PaintX/LSU_4-9_O2_Sensor_Controller/README.md

# LSU_4-9_O2_Sensor_Controller
Controlleur pour sonde lambda LSU 4.9 avec arduino
