PaintX/LSU_4-9_O2_Sensor_Controller/(list of files, drawings)

Other design files:
Orig/schematics/HF-TeensyPP20.pcb
