PaintX/LSU_4-9_O2_Sensor_Controller/PCB/LO2SC.kicad_pcb

## KiCad design PCB/LO2SC.kicad_pcb (2015-09-24)

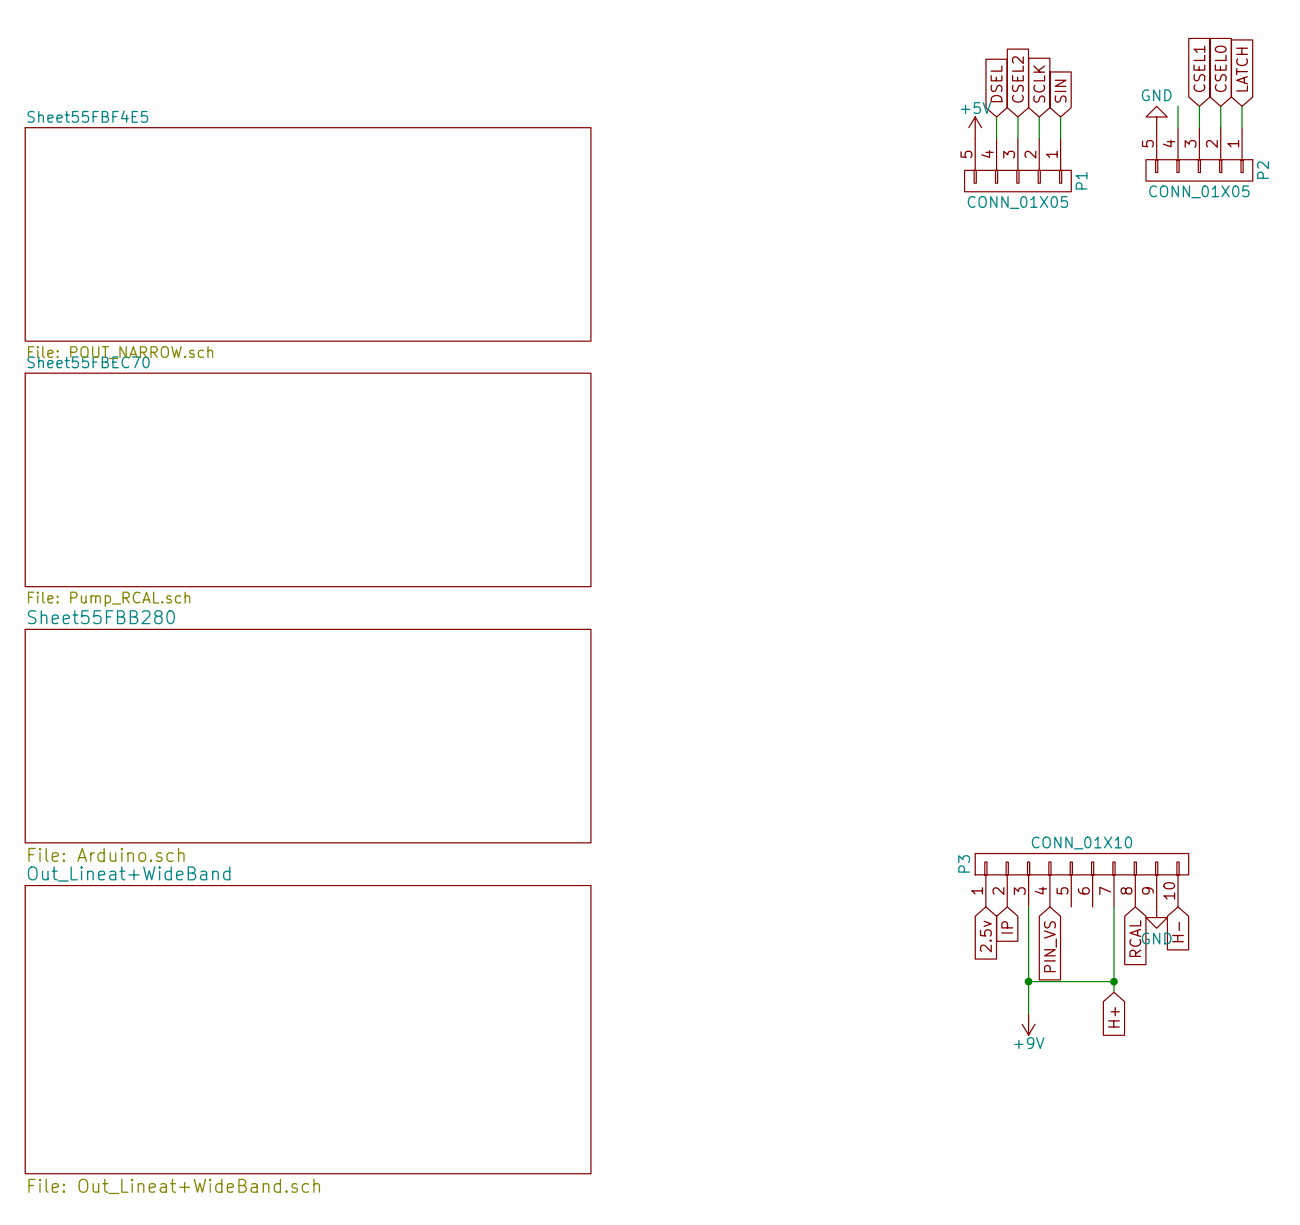
[picture p1: schematic LO2SC.sch]

Parts:
P1, P2: CONN_01X05; Pin_Header_Straight_1x05
P3: CONN_01X10; JAE_10Pins

Connections:
2.5v: P3.1; also elsewhere on the board
+5V: P1.5; also elsewhere on the board
CSEL0: P2.2; also elsewhere on the board
CSEL1: P2.3; also elsewhere on the board
CSEL2: P1.3; also elsewhere on the board
DSEL: P1.4; also elsewhere on the board
GND: P2.5, P3.9; also elsewhere on the board
H+: P3.3, P3.7
IP: P3.2; also elsewhere on the board
LATCH: P2.1; also elsewhere on the board
PIN_VS: P3.4; also elsewhere on the board
RCAL: P3.8; also elsewhere on the board
SCLK: P1.2; also elsewhere on the board
SIN: P1.1; also elsewhere on the board

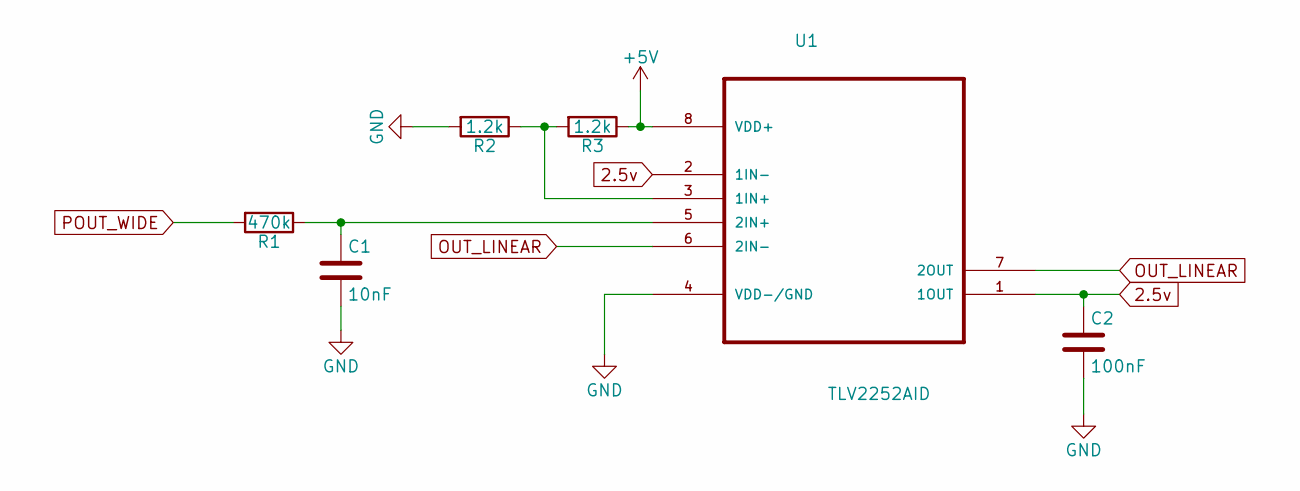
[picture p2: schematic Out_Lineat+WideBand.sch]

Parts:
C1: 10nF; C_0603_HandSoldering
C2: 100nF; C_0603_HandSoldering
R1: 470k; R_0603_HandSoldering
R2, R3: 1.2k; R_0603_HandSoldering
U1: TLV2252AID; SOIC127P600X175-8N

Connections:
2.5v: C2.1, U1.1 (1OUT), U1.2 (1IN-); also elsewhere on the board
+5V: R3.1, U1.8 (VDD+); also elsewhere on the board
GND: C1.2, C2.2, R2.2, U1.4 (VDD-/GND); also elsewhere on the board
unnamed: C1.1, R1.1, U1.5 (2IN+)
unnamed: R2.1, R3.2, U1.3 (1IN+)
OUT_LINEAR: U1.6 (2IN-), U1.7 (2OUT)
POUT_WIDE: R1.2; also elsewhere on the board

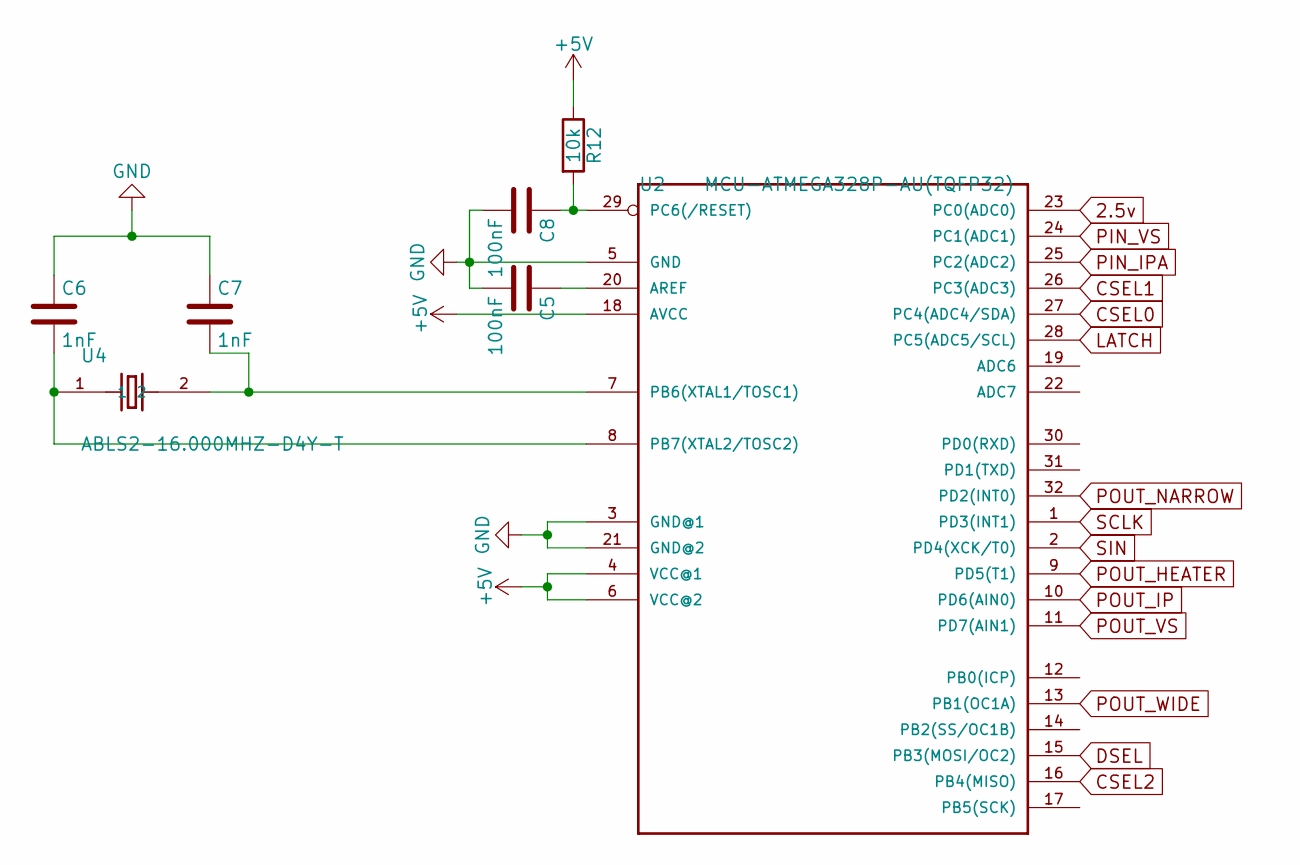
[picture p3: schematic Arduino.sch]

Parts:
C5, C8: 100nF; C_0603_HandSoldering
C6, C7: 1nF; C_0603_HandSoldering
R12: 10k; R_0603_HandSoldering
U2: MCU-ATMEGA328P-AU(TQFP32); TQFP32-0.8-7X7MM
U4: ABLS2-16.000MHZ-D4Y-T; HC-49

Connections:
2.5v: U2.23 (PC0(ADC0)); also elsewhere on the board
+5V: R12.1, U2.4 (VCC@1), U2.6 (VCC@2), U2.18 (AVCC); also elsewhere on the board
CSEL0: U2.27 (PC4(ADC4/SDA)); also elsewhere on the board
CSEL1: U2.26 (PC3(ADC3)); also elsewhere on the board
CSEL2: U2.16 (PB4(MISO)); also elsewhere on the board
DSEL: U2.15 (PB3(MOSI/OC2)); also elsewhere on the board
GND: C5.2, C6.1, C7.1, C8.2, U2.3 (GND@1), U2.5 (GND), U2.21 (GND@2); also elsewhere on the board
LATCH: U2.28 (PC5(ADC5/SCL)); also elsewhere on the board
unnamed: C5.1, U2.20 (AREF)
unnamed: C6.2, U2.8 (PB7(XTAL2/TOSC2)), U4.1
unnamed: C7.2, U2.7 (PB6(XTAL1/TOSC1)), U4.2
unnamed: C8.1, R12.2, U2.29 (PC6(/RESET))
PIN_IPA: U2.25 (PC2(ADC2)); also elsewhere on the board
PIN_VS: U2.24 (PC1(ADC1)); also elsewhere on the board
POUT_IP: U2.10 (PD6(AIN0)); also elsewhere on the board
POUT_NARROW: U2.32 (PD2(INT0)); also elsewhere on the board
POUT_VS: U2.11 (PD7(AIN1)); also elsewhere on the board
POUT_WIDE: U2.13 (PB1(OC1A)); also elsewhere on the board
SCLK: U2.1 (PD3(INT1)); also elsewhere on the board
SIN: U2.2 (PD4(XCK/T0)); also elsewhere on the board

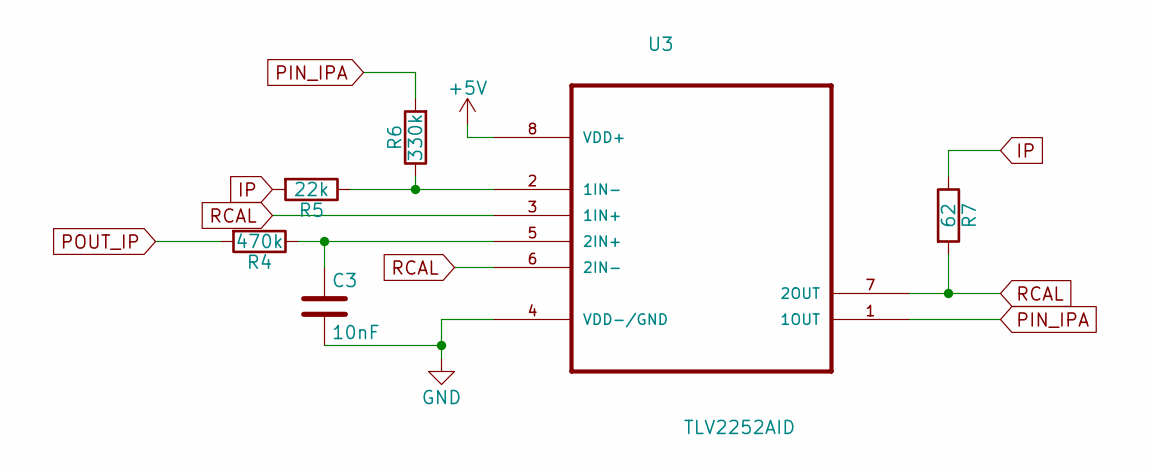
[picture p4: schematic Pump_RCAL.sch]

Parts:
C3: 10nF; C_0603_HandSoldering
R4: 470k; R_0603_HandSoldering
R5: 22k; R_0603_HandSoldering
R6: 330k; R_0603_HandSoldering
R7: 62; R_0603_HandSoldering
U3: TLV2252AID; SOIC127P600X175-8N

Connections:
+5V: U3.8 (VDD+); also elsewhere on the board
GND: C3.2, U3.4 (VDD-/GND); also elsewhere on the board
IP: R5.2, R7.1; also elsewhere on the board
unnamed: C3.1, R4.1, U3.5 (2IN+)
unnamed: R5.1, R6.1, U3.2 (1IN-)
PIN_IPA: R6.2, U3.1 (1OUT); also elsewhere on the board
POUT_IP: R4.2; also elsewhere on the board
RCAL: R7.2, U3.3 (1IN+), U3.6 (2IN-), U3.7 (2OUT); also elsewhere on the board

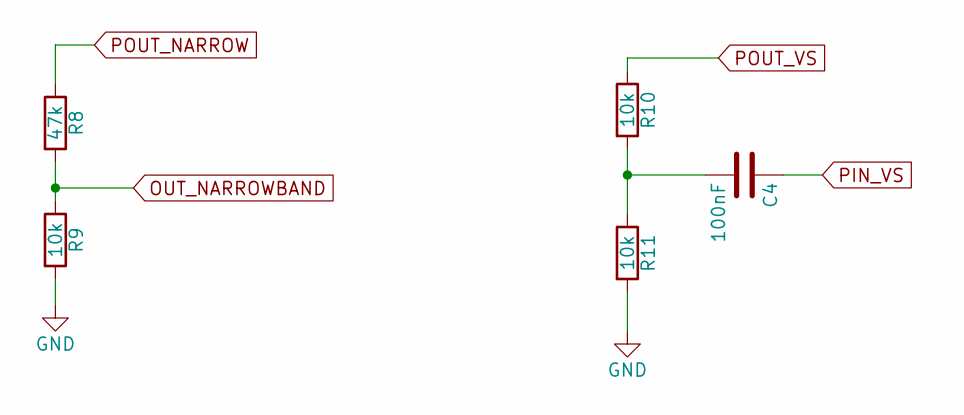
[picture p5: schematic POUT_NARROW.sch]

Parts:
C4: 100nF; C_0603_HandSoldering
R8: 47k; R_0603_HandSoldering
R9, R10, R11: 10k; R_0603_HandSoldering

Connections:
GND: R9.2, R11.2; also elsewhere on the board
unnamed: C4.2, R10.2, R11.1
OUT_NARROWBAND: R8.2, R9.1
PIN_VS: C4.1; also elsewhere on the board
POUT_NARROW: R8.1; also elsewhere on the board
POUT_VS: R10.1; also elsewhere on the board

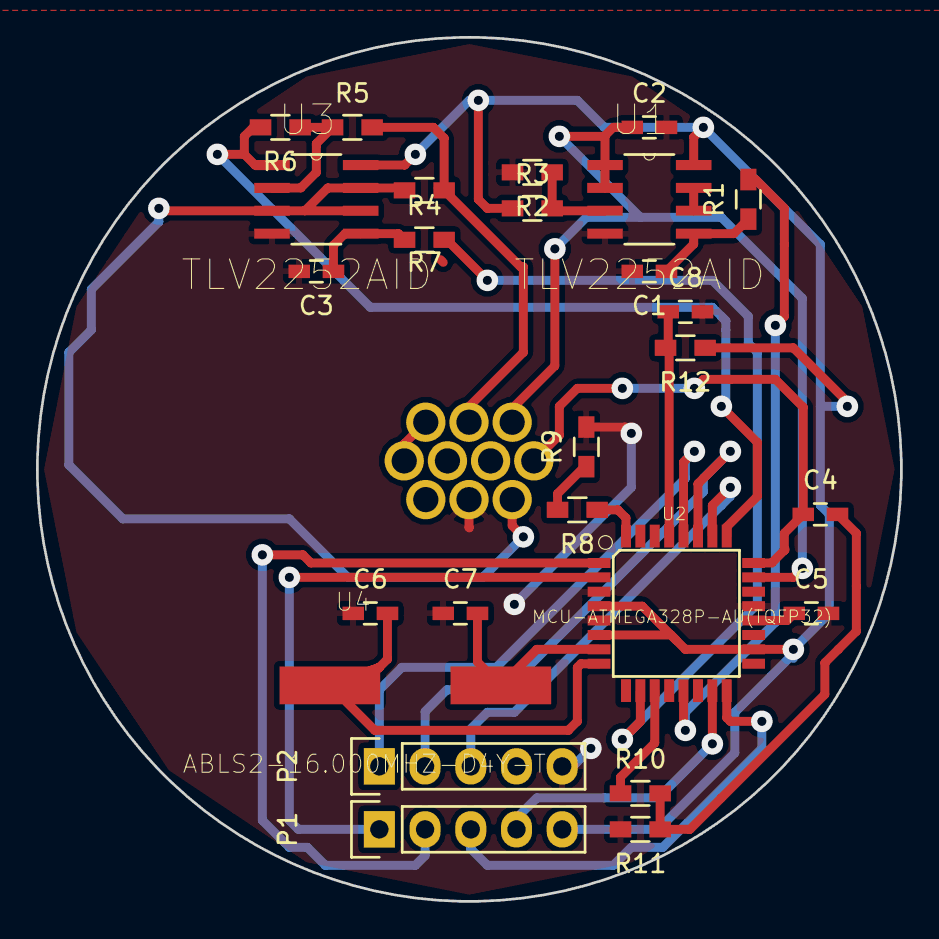
[picture p6: board LO2SC.kicad_pcb from above]

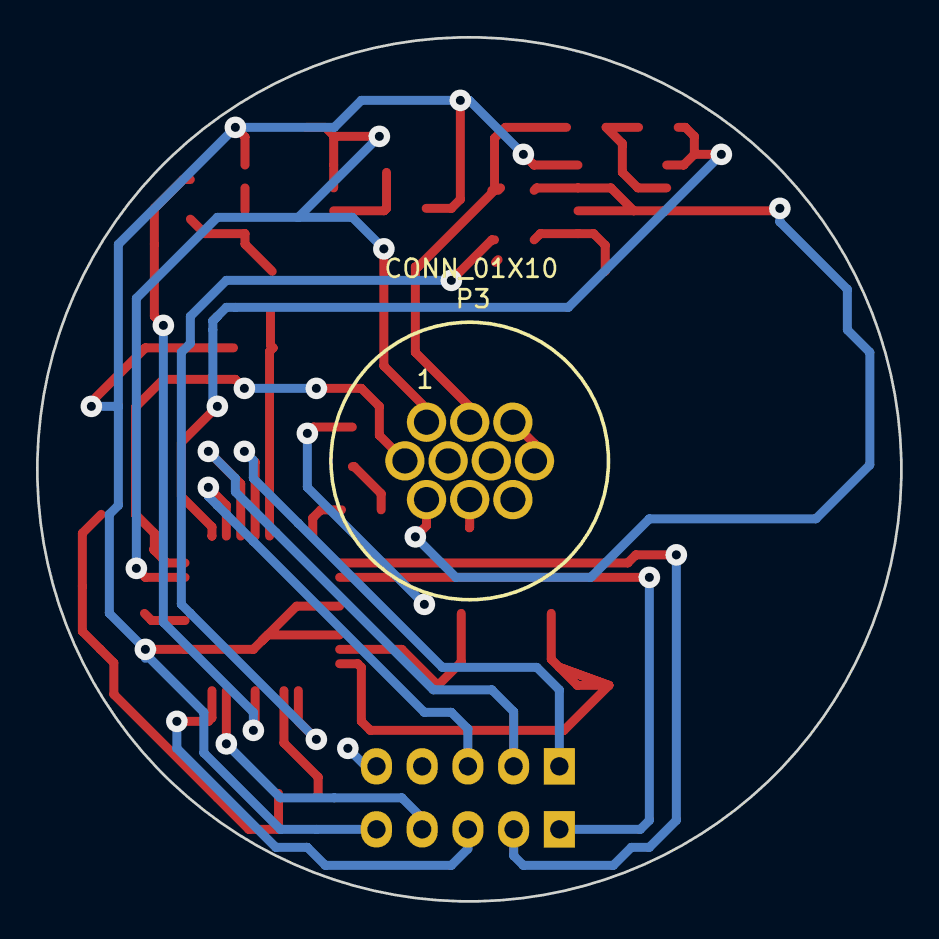
[picture p7: board LO2SC.kicad_pcb from below]

Board: 2 copper layers, 48.0 x 48.0 mm, 28 parts (2 on the bottom side), 30 nets.

Other parts of the board:
Ref**: Val**; vue3D
