PaintX/LSU_4-9_O2_Sensor_Controller/(commit log)

2015-09-17 - ajout fichier original pour tensy ++ 2.0
    [HF-TeensyPP20.pcb, TeensyPP20.sch]
2015-09-17 - Debut de schematique
    [LO2SC.kicad_pcb, LO2SC.sch, Vitual Ground.sch]
2015-09-18 - ajout de schematiques
    [Arduino.sch, LO2SC.kicad_pcb, LO2SC.sch, Out_Lineat+WideBand.sch, POUT_NARROW.sch, Pump_RCAL.sch]
2015-09-21 - premier test avec l'arduino
    [LO2SC.kicad_pcb]
2015-09-22 - routage
    [Arduino.sch, LO2SC.kicad_pcb, LO2SC.sch, Out_Lineat+WideBand.sch, POUT_NARROW.sch, Pump_RCAL.sch]
2015-09-24 - routage en cours
    [LO2SC.kicad_pcb]
